rsk718/esp32-4g-router-watchdog/images/router-4g.jpeg

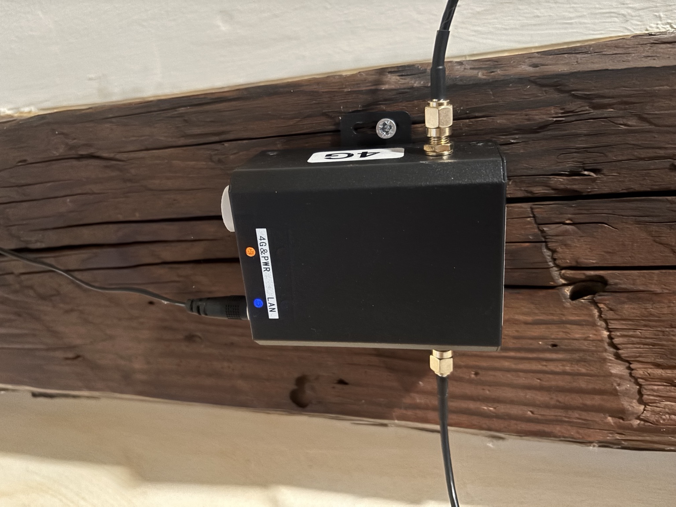
images/router-4g.jpeg
