rsk718/esp32-4g-router-watchdog/images/web-status.jpeg

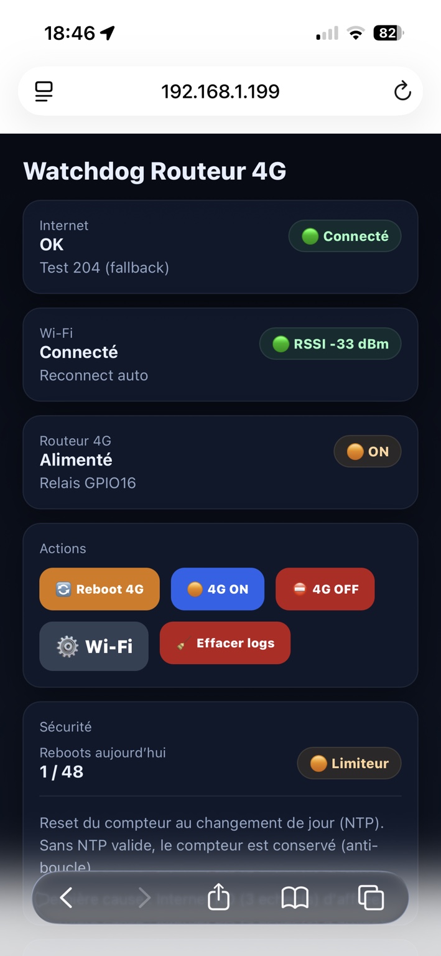
images/web-status.jpeg
