rsk718/esp32-4g-router-watchdog/images/watchdog-installed-wide.jpeg

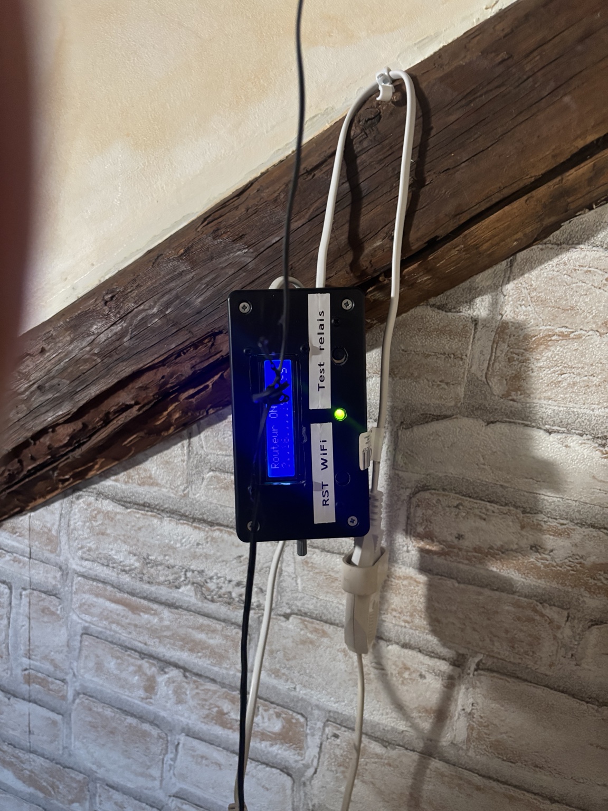
images/watchdog-installed-wide.jpeg
