rsk718/esp32-4g-router-watchdog/images/web-history.png

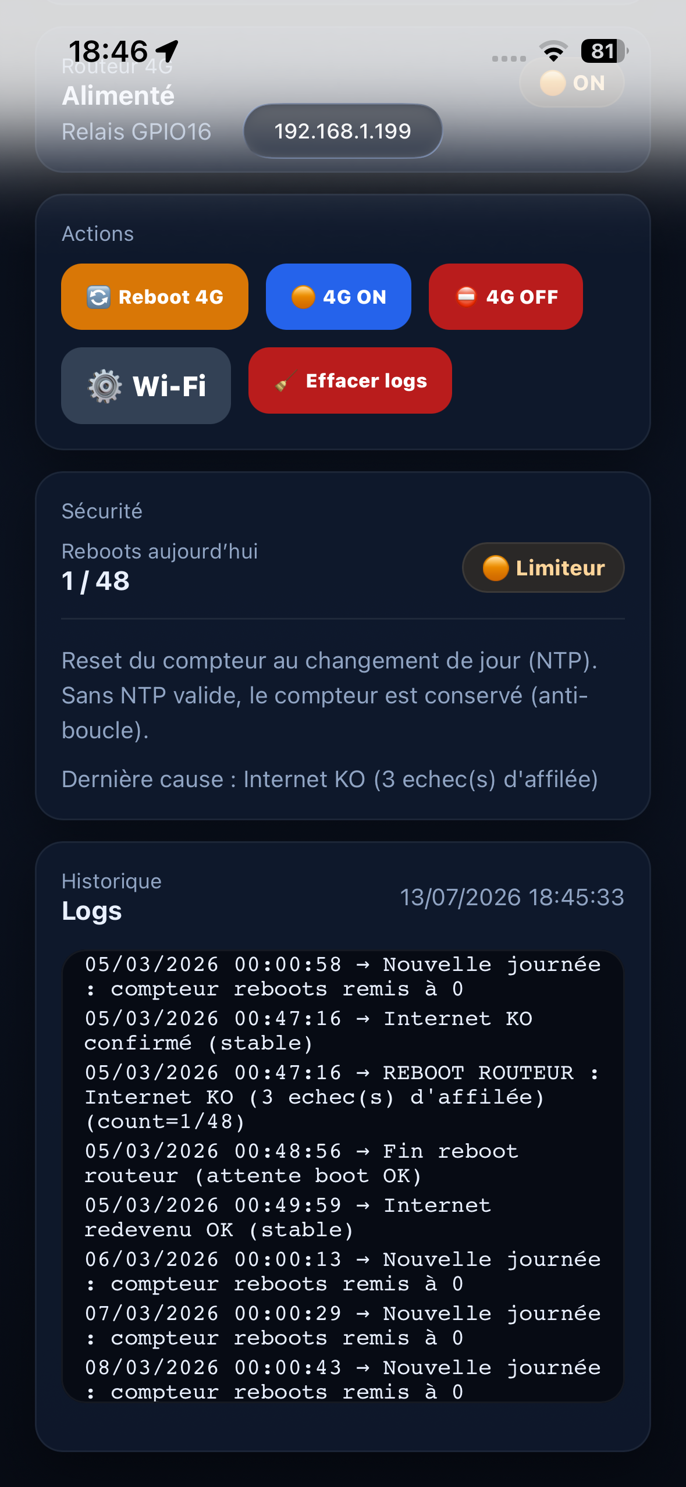
images/web-history.png
