rsk718/esp32-4g-router-watchdog/(commit log)

2026-09-30 Ajout du watchdog 4G et de ses trois versions
2026-10-24 Add files via upload
    detail du prototype
2026-10-24 Documentation : ajout des photos intérieures du watchdog V2.2
2026-10-24 Documentation : rafraîchir la photo de la façade intérieure
